shuki25/wled-esp32-control-board/enclosure/WLED Controller Enclosure.png

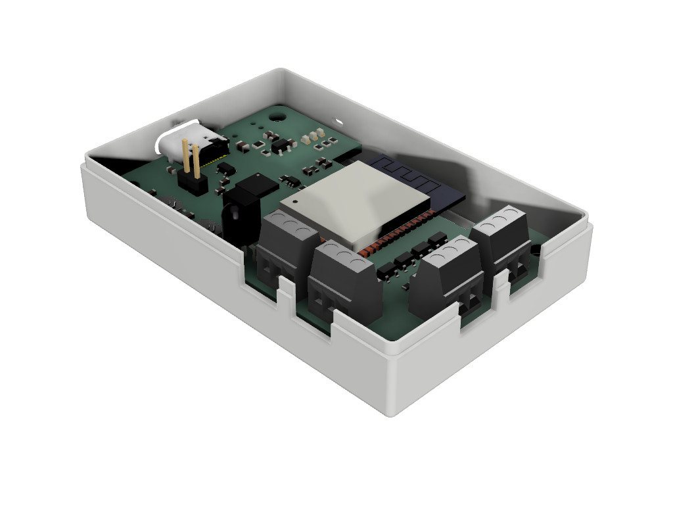
enclosure/WLED Controller Enclosure.png
