shuki25/wled-esp32-control-board/enclosure/wled-controller-enclosure-top.stl

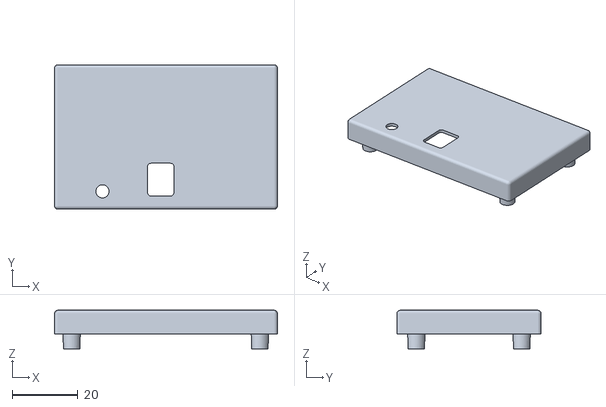
[picture p2: CAD file, 2023-12-31]
enclosure/wled-controller-enclosure-top.stl
68.0 x 44.0 x 11.8
