shuki25/wled-esp32-control-board/enclosure/wled-controller-enclosure-base.stl

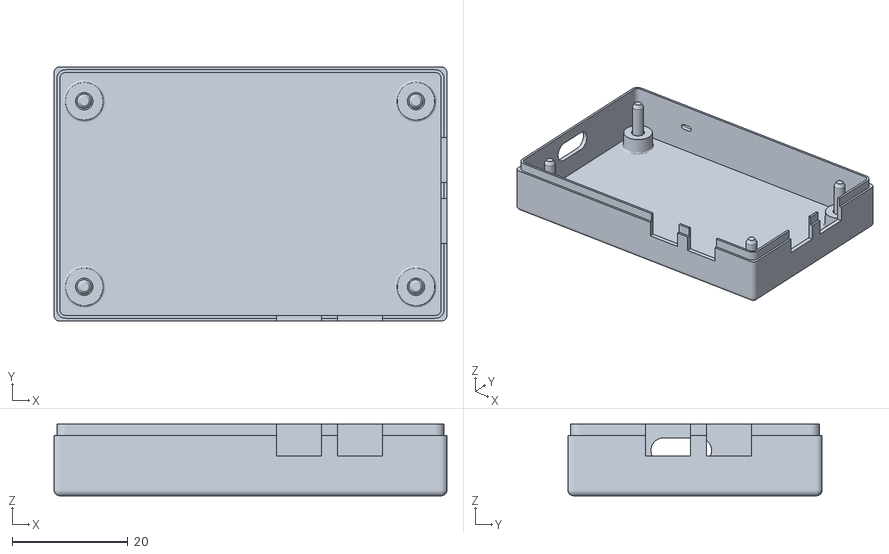
[picture p3: CAD file, 2023-12-31]
enclosure/wled-controller-enclosure-base.stl
68.0 x 44.0 x 12.4
