shuki25/wled-esp32-control-board/pdfs/wled-esp32-control-board__Assembly.pdf

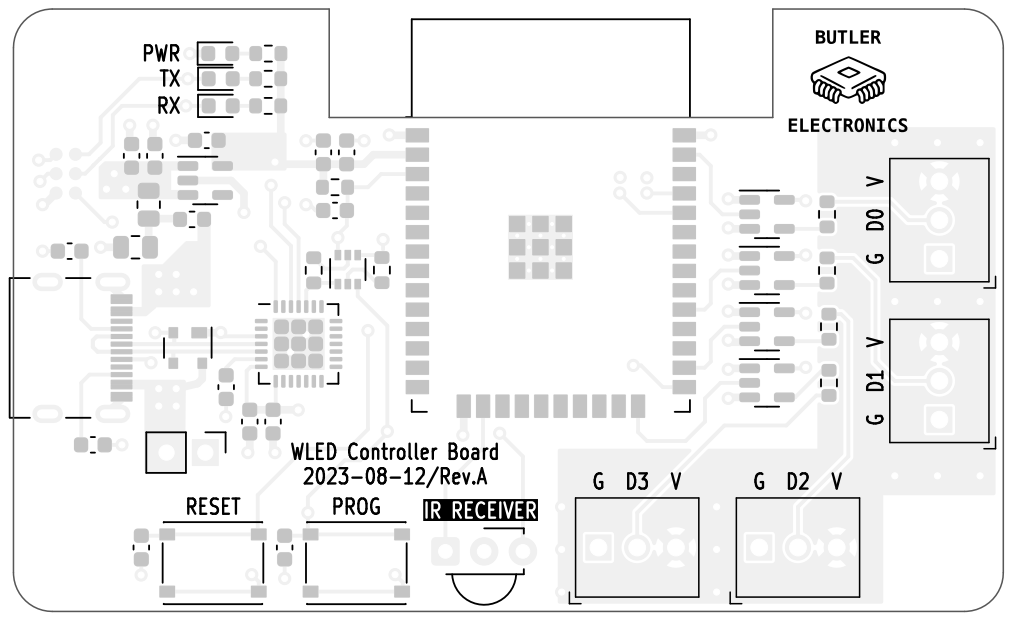
[picture p4: page 1]
D Date: 2023-08-12 KiCad; kicad; 7.0.6-0 Size: A4; Rev: A; File: wled-esp32-control-board.kicad_pcb Sheet: Bulter; Electronics; PWR; WLED Controller; Board; 2023-08-12/Rev.A; PROG; G D2 RESET

Id: 1/1 Title: WLED Controller Board

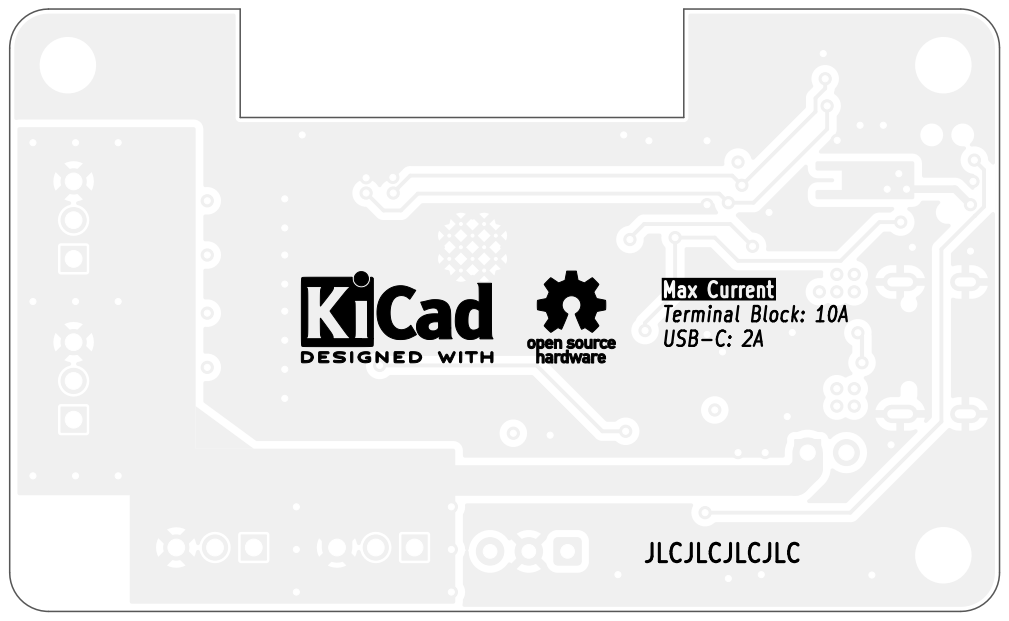
[picture p5: page 2]
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

Id: 1/1 Title: WLED Controller Board
