shuki25/wled-esp32-control-board/pdfs/wled-esp32-control-board.pdf

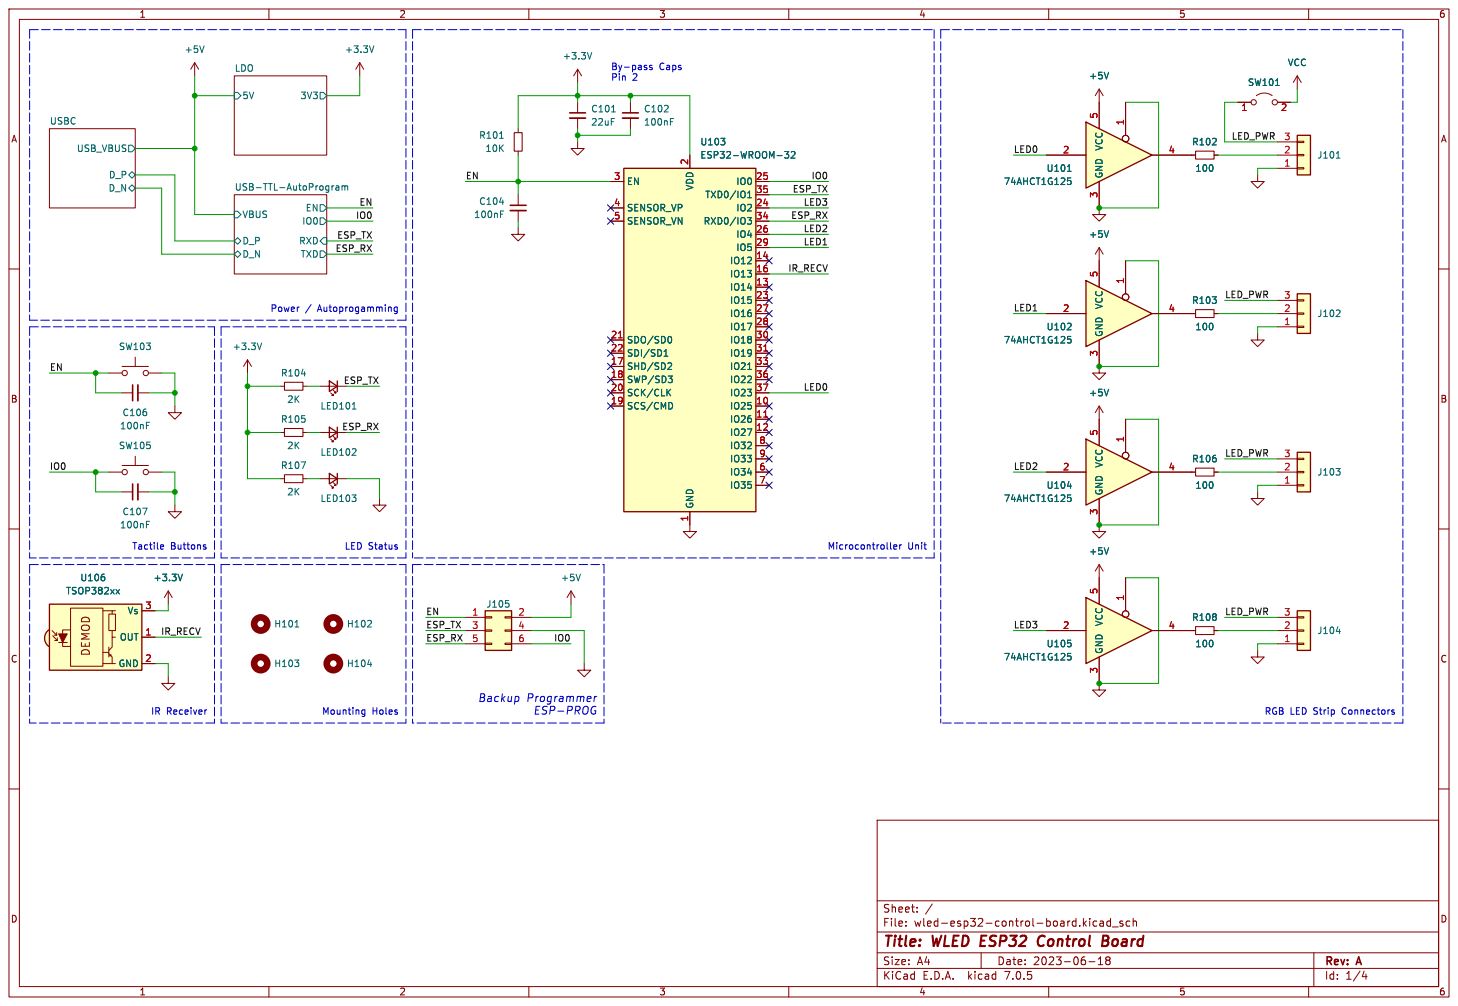
[picture p6: page 1]

2 SCK/CLK 20 SDO/SD0 21 SDI/SD1 22

File: wled-esp32-control-board.kicad_sch Sheet: /
Id: 1/4 Title: WLED ESP32 Control Board

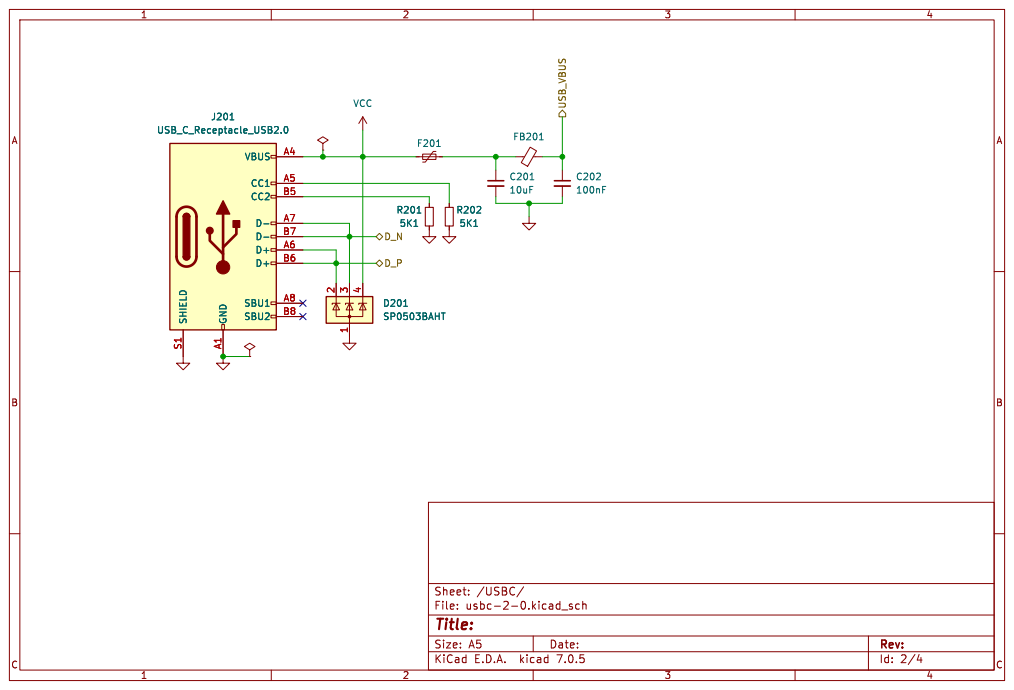
[picture p7: page 2]

Id: 2/4 Title: File: usbc-2-0.kicad_sch Sheet: /USBC/

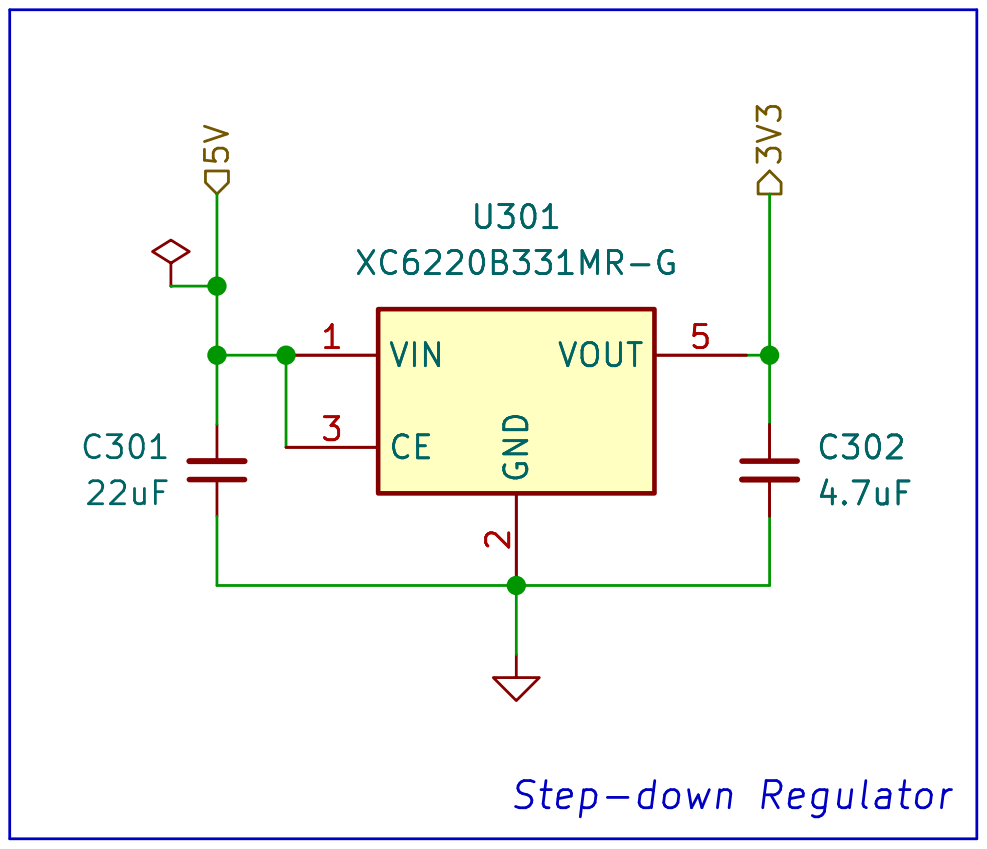
[picture p8: page 3]

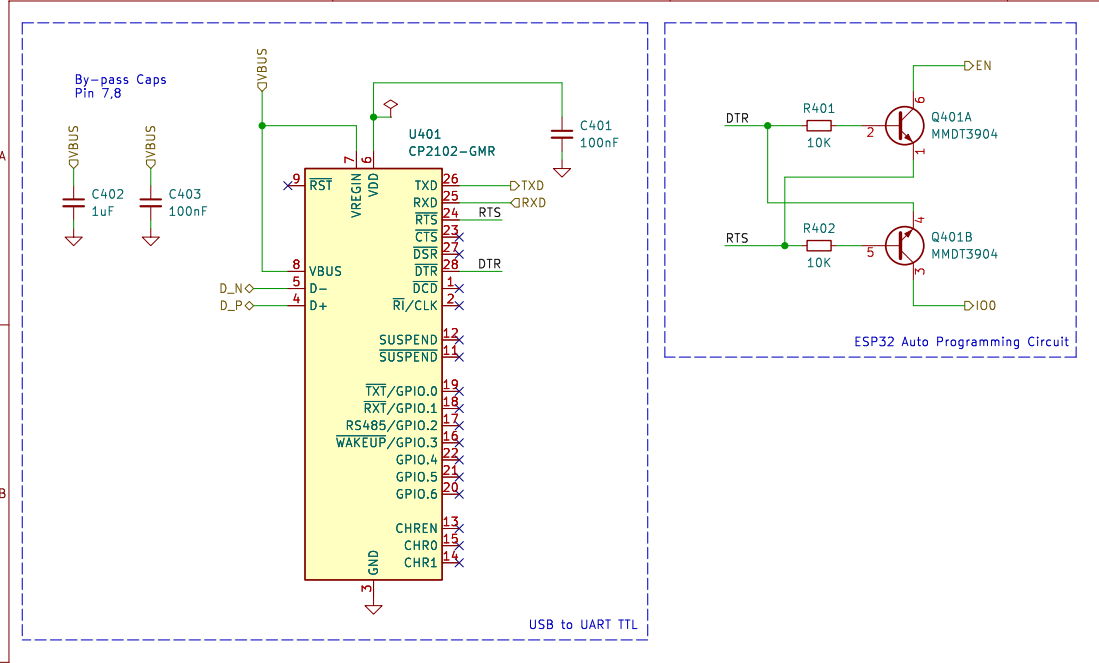
[picture p9: page 4]
