shuki25/wled-esp32-control-board/wled-esp32-control-board.kicad_pcb

## KiCad design wled-esp32-control-board.kicad_pcb (2024-01-15)

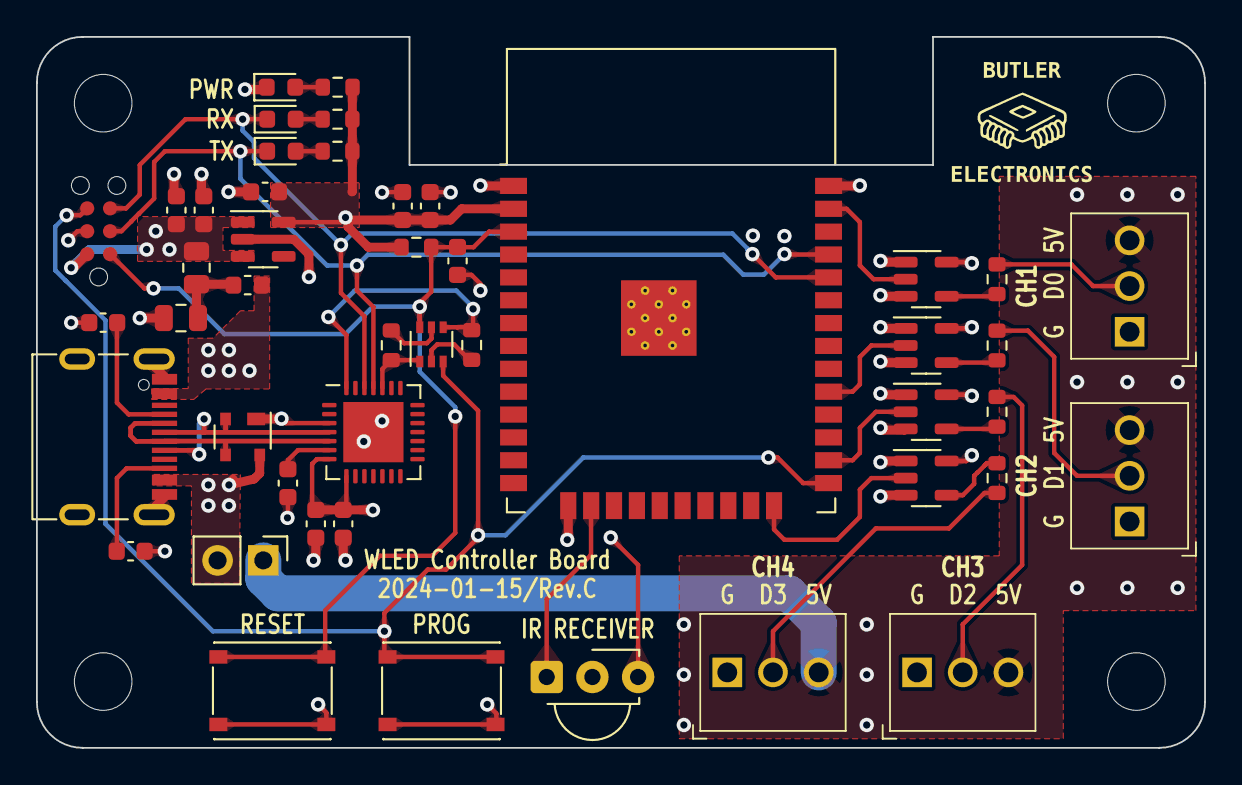
[picture p10: board wled-esp32-control-board.kicad_pcb from above]

Board: 4 copper layers, 64.9 x 39.5 mm, 50 parts (0 on the bottom side), 35 nets.

Parts:
C101, C301: 22uF; C_0603_1608Metric
C102, C104, C202, C401, C403: 100nF; C_0603_1608Metric
C201: 10uF; C_0805_2012Metric
C302: 4.7uF; C_0603_1608Metric
C402: 1uF; C_0603_1608Metric
D201: SP0503BAHT; SOT-143
F201: Polyfuse_Small; Fuse_0603_1608Metric
FB201: FerriteBead_Small; R_0805_2012Metric
H101, H102, H103, H104: MountingHole; MountingHole_3.2mm_M3
J101, J102, J103, J104: Conn_01x03; molex-39773-0003
J105: Conn_02x03_Odd_Even; TC2030-IDC-NL
J201: USB_C_Receptacle_USB2.0; USB_C_Receptable_918-418K2023S40001
LED101: BLUE; LED_0603_1608Metric
LED102: GREEN; LED_0603_1608Metric
LED103: RED; LED_0603_1608Metric
Q401: MMDT3904; SOT-363_SC-70-6
R101, R401, R402: 10K; R_0603_1608Metric
R102, R103, R106, R108: 100; R_0603_1608Metric
R104, R105, R107: 2K; R_0603_1608Metric
R201, R202: 5K1; C_0603_1608Metric
SW101: SW_SPDT; PinHeader_1x02_P2.54mm_Vertical
SW103, SW105: SW_Push; XKB-Connectivity-TS-1187A-B-A-B
U101, U102, U104, U105: 74AHCT1G125; SOT-23-5
U103: ESP32-WROOM-32
U106: TSOP382xx; Vishay_MINICAST-3Pin
U301: XC6220B331MR-G; SOT-23-5
U401: CP2102-GMR; QFN-28-1EP_5x5mm_P0.5mm_EP3.35x3.35mm

Connections:
+3.3V: C101.1, C102.1, C302.1, R101.1, R104.1, R105.1, R107.1, U103.2 (VDD), U106.3 (Vs), U301.5 (VOUT)
+5V: C202.1, C301.2, C402.1, C403.1, FB201.2, J105.2, U101.5 (VCC), U102.5 (VCC), U104.5 (VCC), U105.5 (VCC), U301.1 (VIN), U301.3 (CE), U401.7 (VREGIN), U401.8 (VBUS)
/EN: C104.1, J105.1, Q401.6 (C1), R101.2, SW103.1, U103.3 (EN)
/ESP_RX: J105.5, LED102.1 (K), U103.34 (RXD0/IO3), U401.26 (TXD)
/ESP_TX: J105.3, LED101.1 (K), U103.35 (TXD0/IO1), U401.25 (RXD)
/IO0: J105.6, Q401.3 (C2), SW105.1, U103.25 (IO0)
/IR_RECV: U103.16 (IO13), U106.1 (OUT)
/LED0: U101.2, U103.37 (IO23)
/LED1: U102.2, U103.29 (IO5)
/LED2: U103.26 (IO4), U104.2
/LED3: U103.24 (IO2), U105.2
/LED_PWR: J101.3, J102.3, J103.3, J104.3, SW101.1 (A)
/USB-TTL-AutoProgram/DTR: Q401.4 (E2), R401.2, U401.28 (~DTR)
/USB-TTL-AutoProgram/D_N: D201.3 (K), J201.A7 (D-), J201.B7 (D-), U401.5 (D-)
/USB-TTL-AutoProgram/D_P: D201.2 (K), J201.A6 (D+), J201.B6 (D+), U401.4 (D+)
/USB-TTL-AutoProgram/RTS: Q401.1 (E1), R402.2, U401.24 (~RTS)
GND: C101.2, C102.2, C104.2, C201.2, C202.2, C301.1, C302.2, C401.2, C402.2, C403.2, D201.1 (A), J101.1, J102.1, J103.1, J104.1, J105.4, J201.A1 (GND), J201.A12 (GND), J201.B1 (GND), J201.B12 (GND), J201.S1 (SHIELD), LED103.1 (K), R201.1, R202.1, SW103.2, SW105.2, U101.1, U101.3 (GND), U102.1, U102.3 (GND), U103.1 (GND), U103.15 (GND), U103.38 (GND), U103.39 (GND), U104.1, U104.3 (GND), U105.1, U105.3 (GND), U106.2 (GND), U301.2 (GND), U401.3 (GND), U401.29 (GND)
unnamed: C201.1, F201.2, FB201.1
unnamed: J101.2, R102.2
unnamed: J102.2, R103.2
unnamed: J103.2, R106.2
unnamed: J104.2, R108.2
unnamed: J201.A5 (CC1), R202.2
unnamed: J201.B5 (CC2), R201.2
unnamed: LED101.2 (A), R104.2
unnamed: LED102.2 (A), R105.2
unnamed: LED103.2 (A), R107.2
unnamed: Q401.2 (B1), R401.1
unnamed: Q401.5 (B2), R402.1
unnamed: R102.1, U101.4
unnamed: R103.1, U102.4
unnamed: R106.1, U104.4
unnamed: R108.1, U105.4
unnamed: C401.1, U401.6 (VDD)
VCC: D201.4 (K), F201.1, J201.A4 (VBUS), J201.A9 (VBUS), J201.B4 (VBUS), J201.B9 (VBUS), SW101.2 (B)
