shuki25/wled-esp32-control-board/(commit log)

2023-06-19 update barrel jack
    [wled-esp32-control-board.kicad_sch]
2023-08-12 update schematic
    [cp2102-esp32-autoprogram.kicad_sch, ldo_3V3.kicad_sch, usbc-2-0.kicad_sch, wled-esp32-control-board.kicad_sch]
2023-08-12 update PCB layout/design
    [wled-esp32-control-board.kicad_pcb]
2023-08-12 update production files
    [wled-esp32-control-board-CuBottom.gbr, wled-esp32-control-board-CuIn1.gbr, wled-esp32-control-board-CuIn2.gbr, wled-esp32-control-board-CuTop.gbr, wled-esp32-control-board-EdgeCuts.gbr, wled-esp32-control-board-MaskBottom.gbr, wled-esp32-control-board-MaskTop.gbr, wled-esp32-control-board-NPTH.drl]
2023-08-22 remove caps from tactile button
    [wled-esp32-control-board.kicad_sch]
2023-08-22 reposition cap near EN pin
    Cap repositioned near EN pin. Rev.A does not boot at power on, forcing to press reset button to boot up properly.
    Tactile button caps were removed.
    [wled-esp32-control-board.kicad_pcb]
2023-08-22 update silkscreen labels and revision
    [wled-esp32-control-board.kicad_pcb]
2023-10-05 add schematic pdf
2023-10-24 update BOM status
    [wled-esp32-control-board.kicad_sch]
2023-10-24 update silkscreen and routing
    [wled-esp32-control-board.kicad_pcb]
2023-10-29 fix auto-programmer trace
    Fixed a trace that has narrow connection to resistor, not caught by DRC check. Apparently previous iteration was missed, not sure if it's functioning as intended until next production batch.
    [wled-esp32-control-board.kicad_pcb]
2023-10-29 bump PCB revision
    [wled-esp32-control-board.kicad_pcb]
2023-11-15 fix short traces
    [wled-esp32-control-board.kicad_pcb]
2023-11-15 add teardrops
    [wled-esp32-control-board.kicad_pcb]
2023-11-15 minor tweaks
    minor tweaks
    [wled-esp32-control-board.kicad_pcb]
2023-11-17 update parts
    [usbc-2-0.kicad_sch, wled-esp32-control-board.kicad_pcb]
2023-11-17 add mouser part numbers
    [cp2102-esp32-autoprogram.kicad_sch, ldo_3V3.kicad_sch, usbc-2-0.kicad_sch, wled-esp32-control-board.csv, wled-esp32-control-board.kicad_pcb, wled-esp32-control-board.kicad_sch, wled-esp32-control-board.xlsx]
2023-11-28 add panelization
    [wled-esp32-control-board.csv, wled-esp32-control-board.xlsx]
2023-12-31 add enclosure STL files
    [wled-controller-enclosure-base.stl, wled-controller-enclosure-top.stl]
2023-12-31 update stl files
    [wled-controller-enclosure-base.stl, wled-controller-enclosure-top.stl]
2024-01-01 add fusion 360 files for enclosure
2024-01-15 add origin point for drilling and assembly files
    [wled-esp32-control-board.kicad_pcb]
2024-01-15 revise silkscreen text
    [wled-esp32-control-board.kicad_pcb]
